ikatkov/3d-printing/wall-cylinder-light/xt60.jpeg

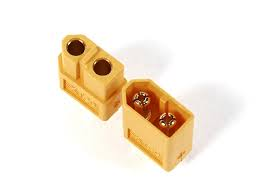
wall-cylinder-light/xt60.jpeg
