ikatkov/3d-printing/wall-cylinder-light/handle.stl

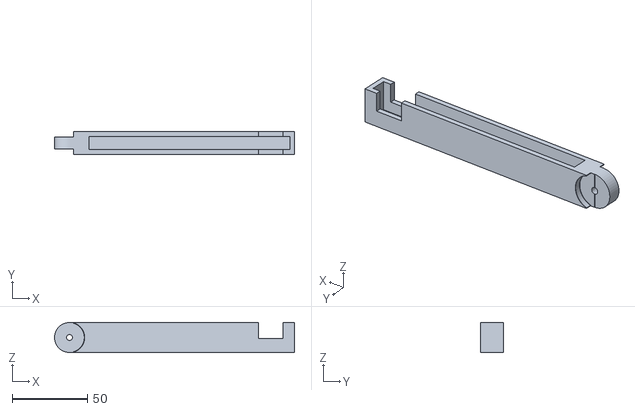
[picture p10: CAD file, 2020-06-29]
wall-cylinder-light/handle.stl
160.0 x 15.0 x 20.0
