ikatkov/3d-printing/wall-cylinder-light/plug.stl

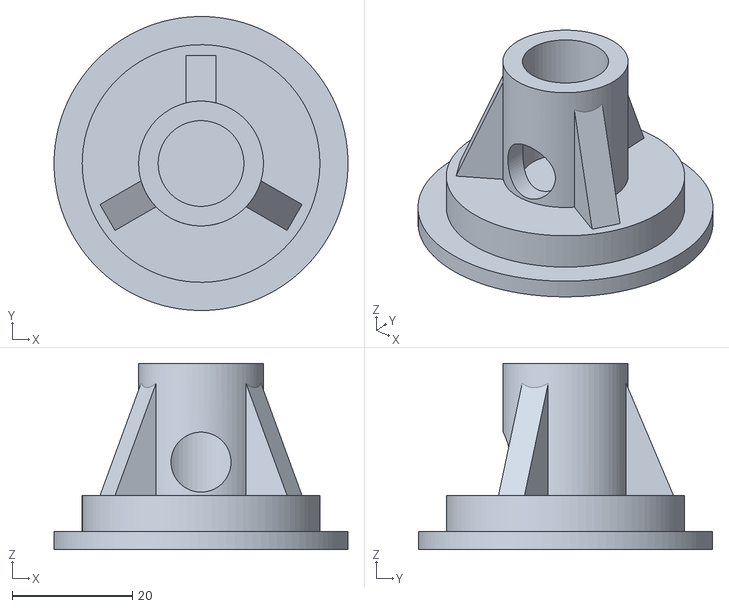
[picture p11: CAD file, 2020-06-29]
wall-cylinder-light/plug.stl
49.0 x 49.0 x 31.0
