ikatkov/3d-printing/wall-cylinder-light/pipe.stl

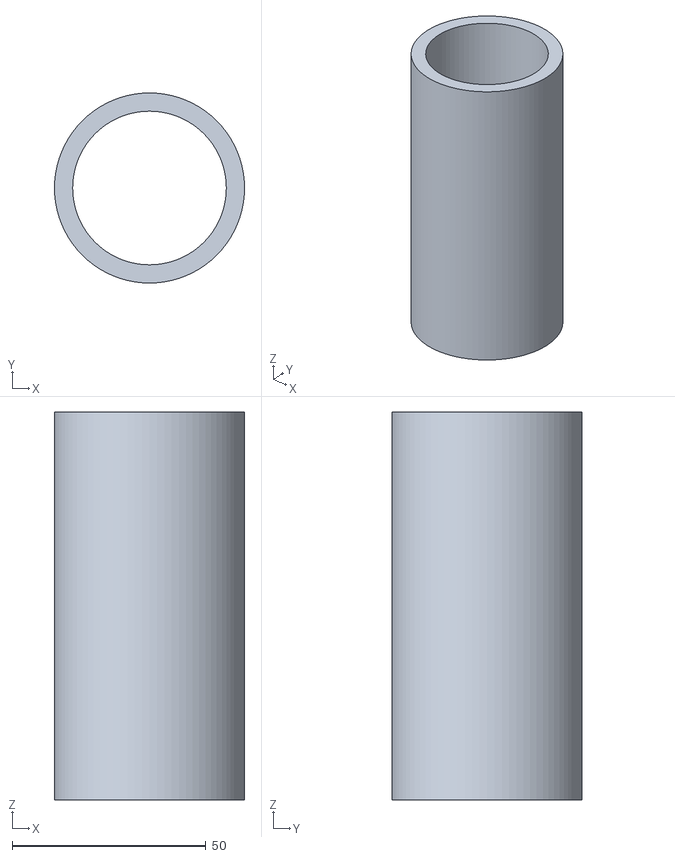
[picture p12: CAD file, 2020-06-29]
wall-cylinder-light/pipe.stl
49.0 x 49.0 x 100.0
