ikatkov/3d-printing/wall-cylinder-light/plate.stl

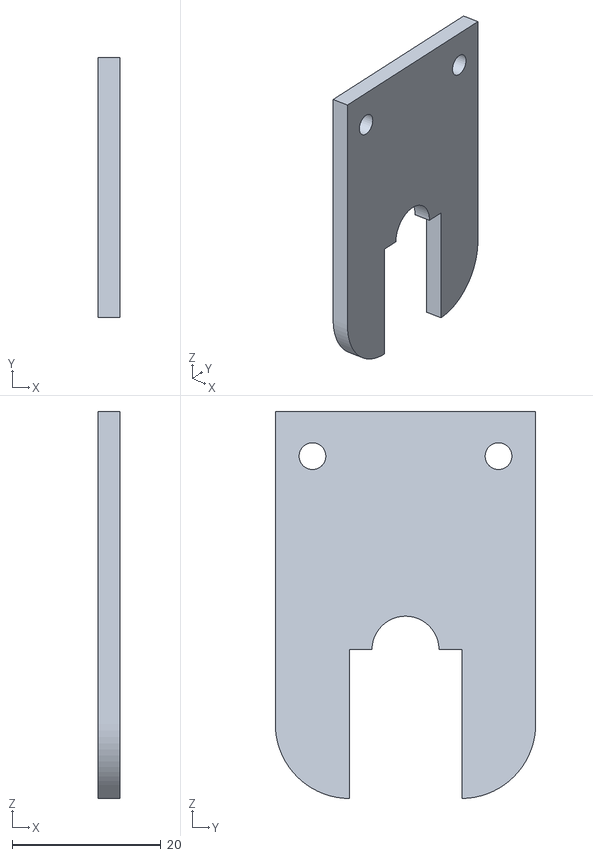
[picture p13: CAD file, 2020-06-29]
wall-cylinder-light/plate.stl
3.00 x 35.0 x 52.0
