ikatkov/3d-printing/wall-cylinder-light/cylinder-handle.stl

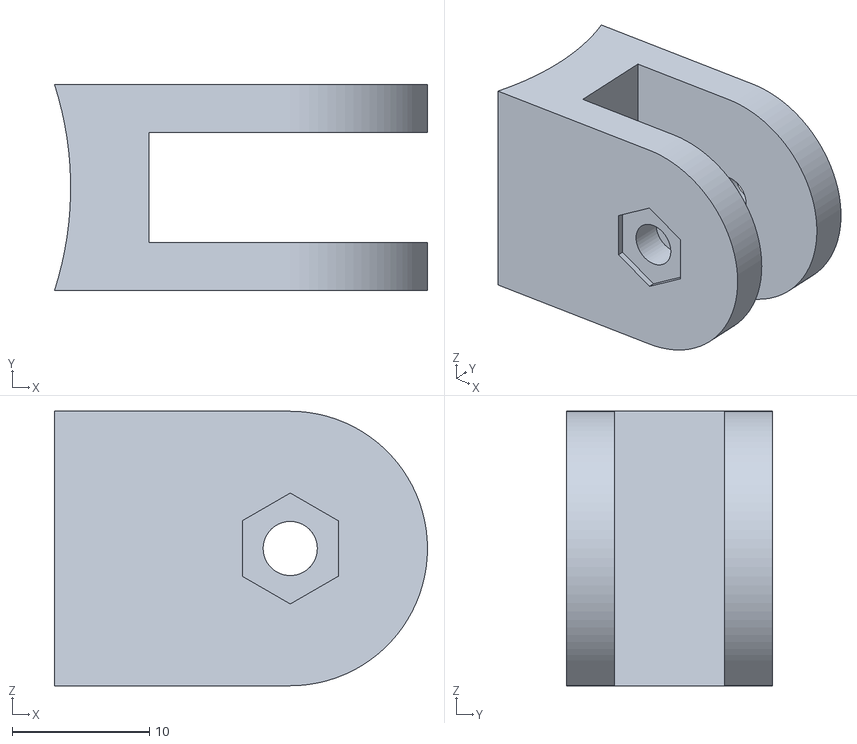
[picture p14: CAD file, 2020-06-29]
wall-cylinder-light/cylinder-handle.stl
27.2 x 15.0 x 20.0
