ikatkov/3d-printing/(list of files, cad)

Other CAD files:
wall-cylinder-light/fusion360-model.f3d
